gabrielbrunheira/project-reggae/proof-of-concepts/poc_oled_ssd1306/images/IMG_20241103_191800.jpg

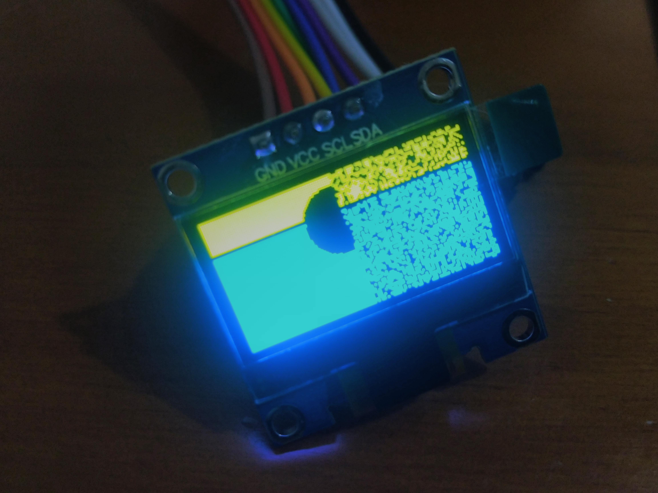
proof-of-concepts/poc_oled_ssd1306/images/IMG_20241103_191800.jpg
