gabrielbrunheira/project-reggae/README.md

# project-reggae
RTOS-based Environmental Data and Garden Automation Experiment
