gabrielbrunheira/project-reggae/docs/datasheets/en.bd-stm32g474.jpg

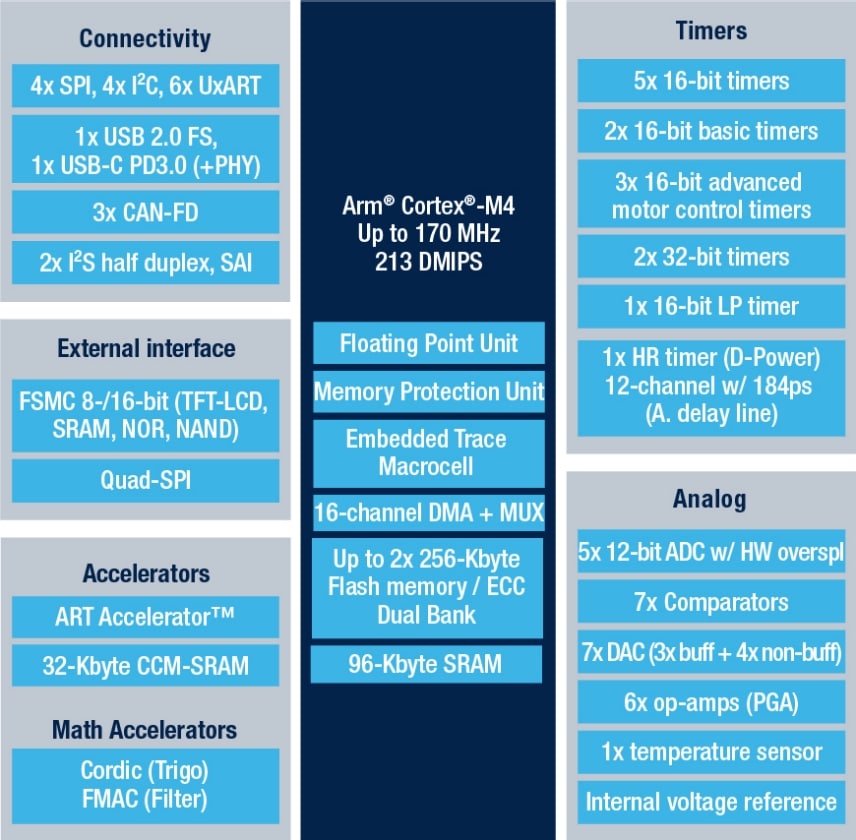
docs/datasheets/en.bd-stm32g474.jpg
