gabrielbrunheira/project-reggae/schematics/Esquematico.png

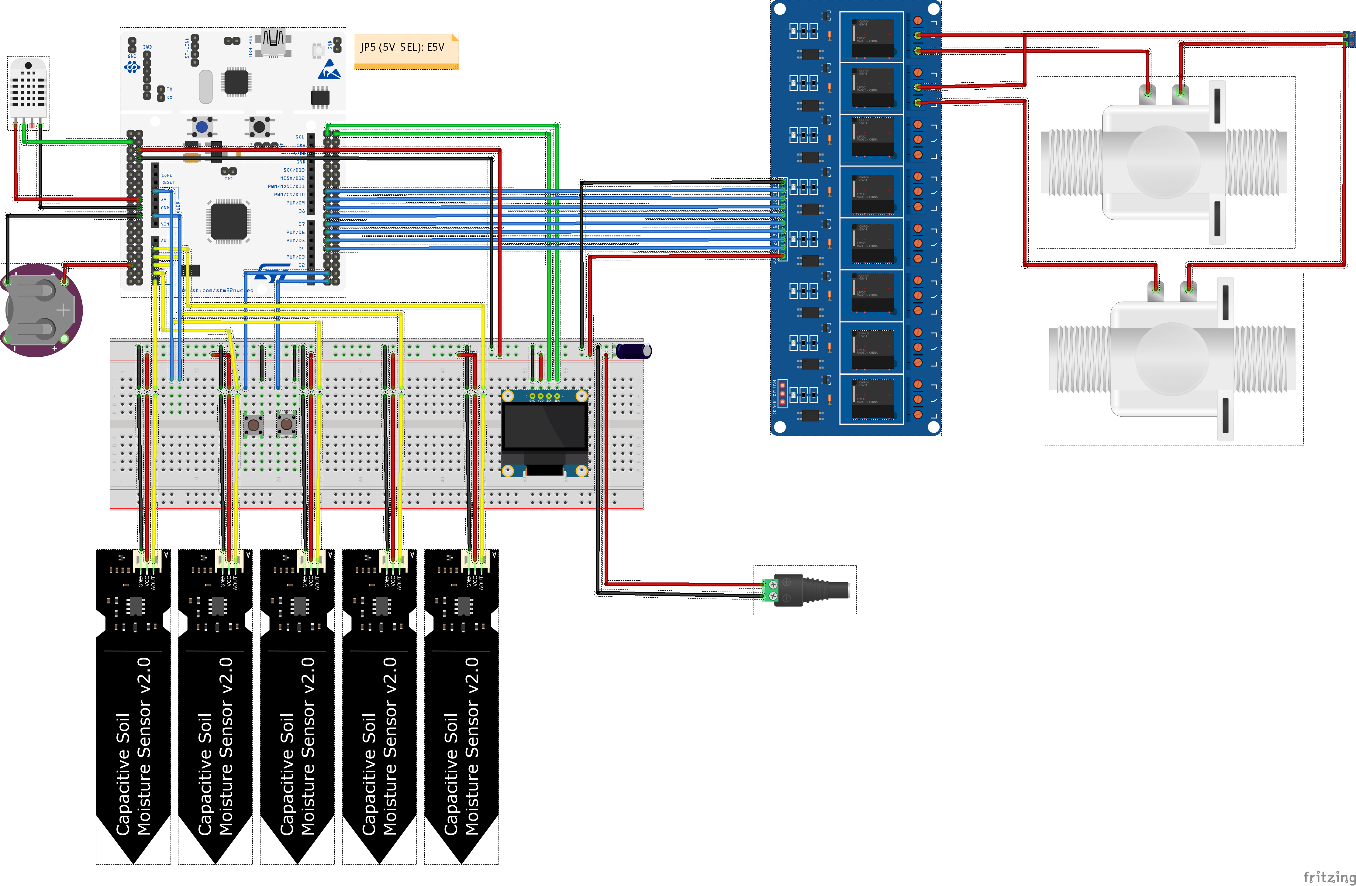
schematics/Esquematico.png
