gabrielbrunheira/project-reggae/(list of files, drawings)

Other design files:
schematics/Esquematico.fzz
schematics/Esquematico_v2.fzz
