gabrielbrunheira/project-reggae/firmware/Core/Inc/main.h

#define B1_Pin GPIO_PIN_13
#define B1_GPIO_Port GPIOC
#define B1_EXTI_IRQn EXTI15_10_IRQn
#define LPUART1_TX_Pin GPIO_PIN_2
#define LPUART1_TX_GPIO_Port GPIOA
#define LPUART1_RX_Pin GPIO_PIN_3
#define LPUART1_RX_GPIO_Port GPIOA
#define LD2_Pin GPIO_PIN_5
#define LD2_GPIO_Port GPIOA
#define BUTTON_SELECT_Pin GPIO_PIN_6
#define BUTTON_SELECT_GPIO_Port GPIOA
#define BUTTON_SELECT_EXTI_IRQn EXTI9_5_IRQn
#define RELAY1_Pin GPIO_PIN_7
#define RELAY1_GPIO_Port GPIOA
#define RELAY3_Pin GPIO_PIN_7
#define RELAY3_GPIO_Port GPIOC
#define RELAY4_Pin GPIO_PIN_9
#define RELAY4_GPIO_Port GPIOA
#define BUTTON_TOGGLE_Pin GPIO_PIN_10
#define BUTTON_TOGGLE_GPIO_Port GPIOA
#define BUTTON_TOGGLE_EXTI_IRQn EXTI15_10_IRQn
#define T_SWDIO_Pin GPIO_PIN_13
#define T_SWDIO_GPIO_Port GPIOA
#define T_SWCLK_Pin GPIO_PIN_14
#define T_SWCLK_GPIO_Port GPIOA
#define DHT11_Pin GPIO_PIN_12
#define DHT11_GPIO_Port GPIOC
#define T_SWO_Pin GPIO_PIN_3
#define T_SWO_GPIO_Port GPIOB
#define RELAY2_Pin GPIO_PIN_6
#define RELAY2_GPIO_Port GPIOB
