gabrielbrunheira/project-reggae/proof-of-concepts/poc_oled_ssd1306/Core/Src/main.c

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
/* Includes ------------------------------------------------------------------*/
#include "main.h"

/* USER CODE BEGIN Includes */
#include "ssd1306.h"
#include "ssd1306_fonts.h"
/* USER CODE END Includes */

I2C_HandleTypeDef hi2c1;

UART_HandleTypeDef hlpuart1;

/* USER CODE BEGIN PV */
const unsigned char garfield_128x64 [] = {
0x00, 0x00, 0x00, 0x00, 0x00, 0x00, 0x00, 0x00, 0x00, 0x00, 0x00, 0x00, 0x00, 0x00, 0x00, 0x00,
0x00, 0x00, 0x00, 0x00, 0x00, 0x07, 0xFF, 0x00, 0x00, 0x00, 0x00, 0x00, 0x00, 0x00, 0x00, 0x00,
0x00, 0x00, 0x00, 0x00, 0x00, 0x1F, 0xFF, 0xF8, 0x7F, 0xE0, 0x00, 0x00, 0x00, 0x00, 0x00, 0x00,
0x00, 0x00, 0x00, 0x00, 0x00, 0x3F, 0xFF, 0xCF, 0xFF, 0xFE, 0x00, 0x00, 0x00, 0x00, 0x00, 0x00,
0x00, 0x00, 0x00, 0x00, 0x00, 0x3F, 0xFB, 0xE3, 0xFF, 0xF3, 0x80, 0x00, 0x00, 0x00, 0x00, 0x00,
0x00, 0x00, 0x00, 0x00, 0x00, 0x3F, 0xC0, 0xF3, 0xFF, 0xF8, 0xE0, 0x00, 0x00, 0x00, 0x00, 0x00,
0x00, 0x00, 0x00, 0x00, 0x00, 0x1F, 0x00, 0x1F, 0xD9, 0xFC, 0x38, 0x00, 0x00, 0x00, 0x00, 0x00,
0x00, 0x00, 0x00, 0x00, 0x00, 0x0D, 0x00, 0x0F, 0x00, 0x1E, 0x0C, 0x00, 0x00, 0x00, 0x00, 0x00,
0x00, 0x00, 0x00, 0x00, 0x0C, 0x0C, 0x0E, 0x1F, 0xF8, 0x03, 0x04, 0x00, 0x00, 0x00, 0x00, 0x00,
0x00, 0x00, 0x00, 0x00, 0x03, 0x87, 0xF0, 0x07, 0x00, 0x01, 0x86, 0x00, 0x00, 0x00, 0x00, 0x00,
0x00, 0x00, 0x00, 0x00, 0x18, 0x3B, 0x80, 0x18, 0x00, 0x30, 0xC3, 0x00, 0x00, 0x00, 0x00, 0x00,
0x00, 0x00, 0x00, 0x00, 0x00, 0xFE, 0x00, 0x60, 0x00, 0x18, 0xC3, 0x01, 0xC0, 0x00, 0x00, 0x00,
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
	0xff, 0xff, 0xe3, 0xbd, 0xff, 0xff, 0xff, 0xff, 0xe7, 0xbc, 0xff, 0xff, 0xff, 0xff, 0xe7, 0xbc,
	0xff, 0xff, 0xff, 0xff, 0xe9, 0xb9, 0xff, 0xff, 0xff, 0xff, 0x24, 0x73, 0xff, 0xff, 0xff, 0xfe,
	0xe7, 0xef, 0xff, 0xff, 0xff, 0xff, 0xb7, 0xdf, 0xff, 0xff, 0xff, 0xff, 0xf6, 0x7f, 0xff, 0xff,
	0xff, 0xff, 0xf7, 0x60, 0xff, 0xff, 0xff, 0xff, 0xff, 0x07, 0x7f, 0xff, 0xff, 0xff, 0xef, 0xfd,
	0xbf, 0xff, 0xff, 0xff, 0xdf, 0xfe, 0x3f, 0xff, 0xff, 0xff, 0xbf, 0xd6, 0x3f, 0xff, 0xff, 0xff,
	0x80, 0xd1, 0xff, 0xff, 0xff, 0xff, 0xff, 0x2f, 0xff, 0xff, 0xff, 0xff, 0xff, 0xff, 0xff, 0xff
};

const unsigned char woodstock [] = {
	0xff, 0xff, 0xf0, 0xfb, 0x7f, 0xf0, 0xe9, 0x27, 0xf0, 0xf4, 0x9f, 0xf0, 0xf3, 0xf3, 0xf0, 0xf7,
	0xf9, 0xf0, 0xe7, 0xff, 0xf0, 0x9b, 0xe7, 0xf0, 0x3f, 0xf7, 0xb0, 0x7f, 0x5e, 0x50, 0x3e, 0xbd,
	0xe0, 0x80, 0x85, 0x10, 0xff, 0x05, 0x70, 0xfc, 0x60, 0xf0, 0xfc, 0x78, 0xf0, 0xff, 0x70, 0xf0,
	0xff, 0x84, 0x70, 0xff, 0xf2, 0xf0, 0xff, 0xf2, 0xf0, 0xff, 0xf1, 0xf0
};

/* USER CODE END PV */

void SystemClock_Config(void);
static void MX_GPIO_Init(void);
static void MX_LPUART1_UART_Init(void);
static void MX_I2C1_Init(void);
/**
  * @brief  The application entry point.
  * @retval int
  */
int main(void)
{
  /* MCU Configuration--------------------------------------------------------*/

  /* Reset of all peripherals, Initializes the Flash interface and the Systick. */
  HAL_Init();

  /* Configure the system clock */
  SystemClock_Config();
  /* Initialize all configured peripherals */
  MX_GPIO_Init();
  MX_LPUART1_UART_Init();
  MX_I2C1_Init();
  /* USER CODE BEGIN 2 */
  ssd1306_Init();

  //ssd1306_DrawBitmap(0,0,garfield_128x64,128,64,White);
  //ssd1306_DrawBitmap(0,0,github_logo_64x64,64,64,White);
  ssd1306_FillRectangle(0, 0, 108, 15, White);
  ssd1306_FillRectangle(64, 16, 128, 64, White);
  ssd1306_DrawBitmap(108, 0, woodstock, 20, 20, White);
  ssd1306_DrawBitmap(0,16,snoopy_48x48,48,48,White);
  ssd1306_FillRectangle(48, 16, 64, 63, White);
  ssd1306_UpdateScreen();

  /*HAL_Delay(3000);
  ssd1306_Fill(Black);

  ssd1306_FillRectangle(0, 0, 128, 15, White);

  ssd1306_SetCursor(4,4);
  ssd1306_WriteString("6x8", Font_6x8, Black);

  ssd1306_SetCursor(26,3);
  ssd1306_WriteString("7x10", Font_7x10, Black);

  ssd1306_SetCursor(0,16);
  ssd1306_WriteString("16x15", Font_16x15, White);

  ssd1306_SetCursor(0,31);
  ssd1306_WriteString("11x18", Font_11x18, White);

  //ssd1306_SetCursor(0,16);
  //ssd1306_WriteString("16x26", Font_16x26, White);

  //ssd1306_SetCursor(0,40);
  //ssd1306_WriteString("16x24", Font_16x24, White);

  ssd1306_DrawCircle(7, 56, 7, White);
  ssd1306_DrawRectangle(21, 49, 35, 63, White);

  // Draw a triangle
  SSD1306_VERTEX vertexes[4];
  vertexes[0] = (SSD1306_VERTEX){.x = 47, .y = 49};
  vertexes[1] = (SSD1306_VERTEX){.x = 40, .y = 63};
  vertexes[2] = (SSD1306_VERTEX){.x = 54, .y = 63};
  vertexes[3] = (SSD1306_VERTEX){.x = 47, .y = 49};
  ssd1306_Polyline(vertexes, 4, White);

  ssd1306_UpdateScreen();*/
  /* USER CODE END 2 */

  /* Infinite loop */
  /* USER CODE BEGIN WHILE */
  while (1)
  {
    /* USER CODE END WHILE */

    /* USER CODE BEGIN 3 */
  }
  /* USER CODE END 3 */
}

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
