gabrielbrunheira/project-reggae/(commit log)

2024-10-19 Include schematics, first docs and datasheets
    [Cronograma.xlsx, Esquematico.fzz, Orçamento.xlsx]
2024-10-25 Create template for slides, include log memory specs, rename docx file
    [Especificacao do Software.xlsx]
2024-10-28 Update RTOS componenents, start Etapa 2 slides
    [Especificacao do Software.xlsx]
2024-10-29 Finish first version of software specification
    [Cronograma.xlsx, Especificacao do Software.xlsx]
2024-11-04 Include lib and proof-of-concepts of OLED display
    [Cronograma.xlsx, Especificacao do Software.xlsx]
2024-11-06 Include soil capacitive sensor and RTC proof of concepts
2024-11-08 Place HAL_RTC_GetTime before HAL_RTC_GetDate to fix bug and maintain consistency in RTC POC
    [main.c]
2024-11-09 Fix OLED driver width configuration
    [main.c, main.h, oled_ssd1306_test.ioc]
2024-11-11 Enable TIM7 (timer 7) to be used as 1 us timer for DHT11 driver
2024-11-11 Include DHT11 and display drivers
2024-11-12 Implement some tasks, buttons ISR, display task
    [Especificacao do Software.xlsx, Esquematico_v2.fzz]
